wouldgo/eth-camera/hardware/tray.stl

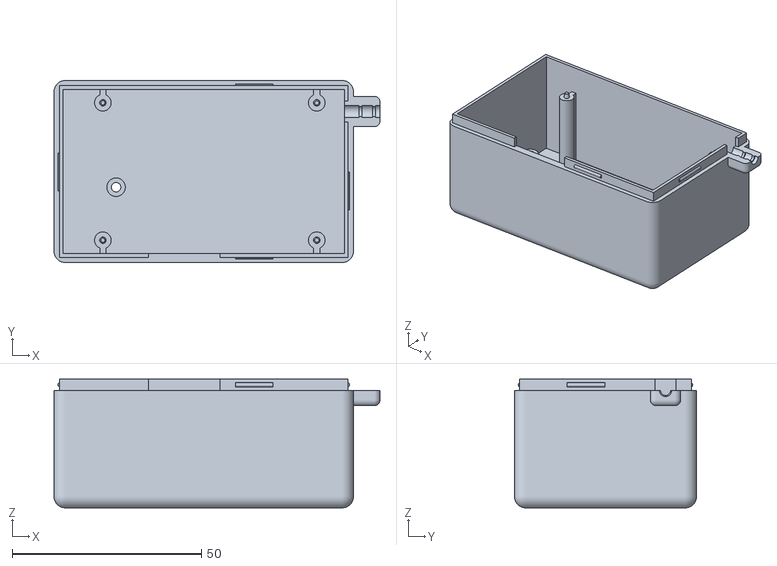
[picture p1: CAD file, 2026-10-19]
hardware/tray.stl
86.1 x 48.1 x 34.0
