wouldgo/eth-camera/hardware/meter_mount.stl

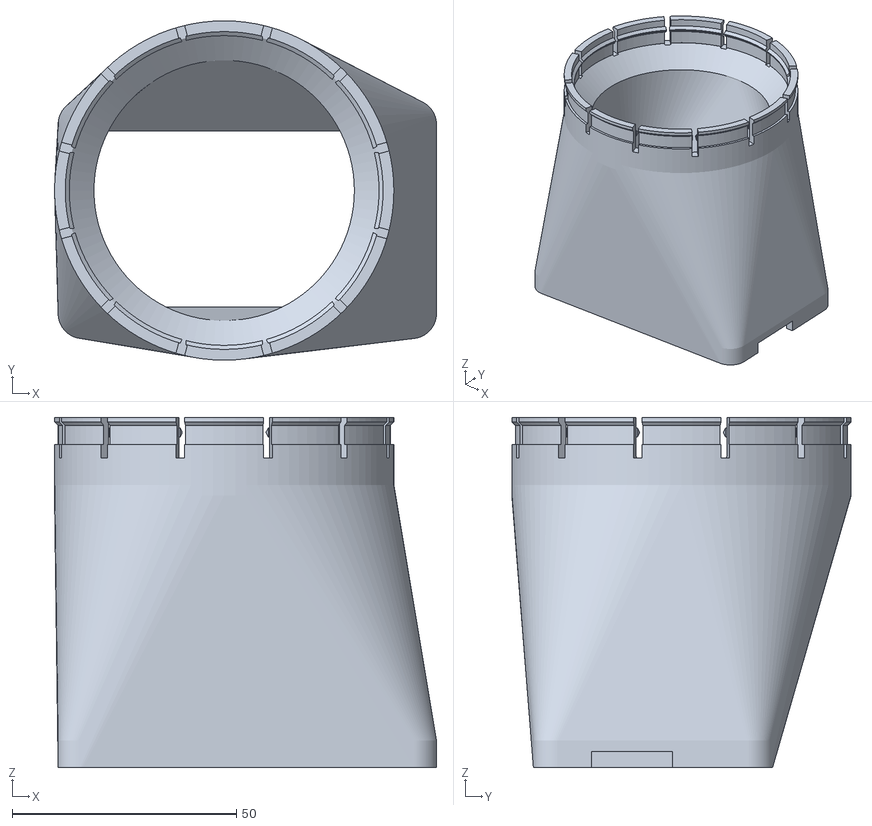
[picture p2: CAD file, 2026-10-19]
hardware/meter_mount.stl
85.1 x 75.6 x 78.0
