wouldgo/eth-camera/hardware/lid.stl

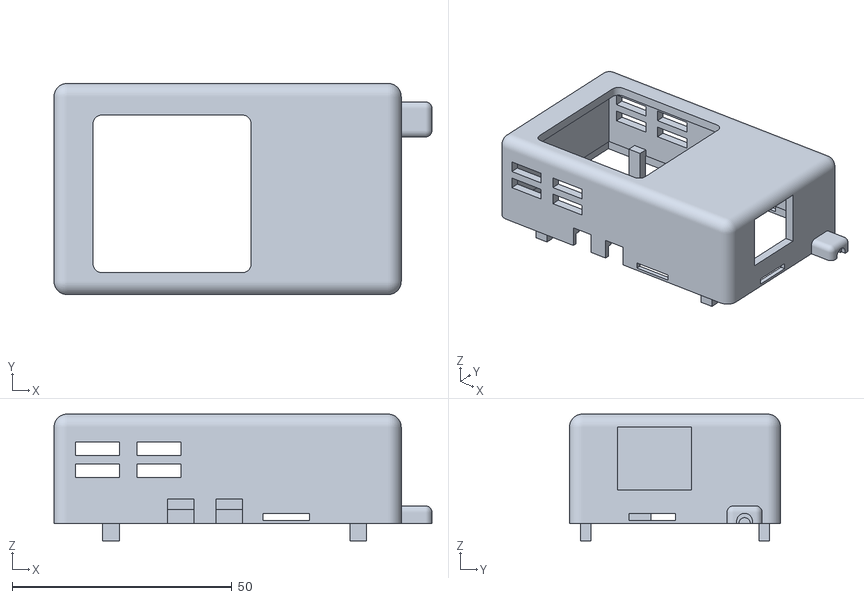
[picture p3: CAD file, 2026-10-19]
hardware/lid.stl
86.1 x 48.1 x 28.9
