wouldgo/eth-camera/hardware/eth-camera.kicad_sch

## KiCad design hardware/eth-camera.kicad_sch (2026-10-19)

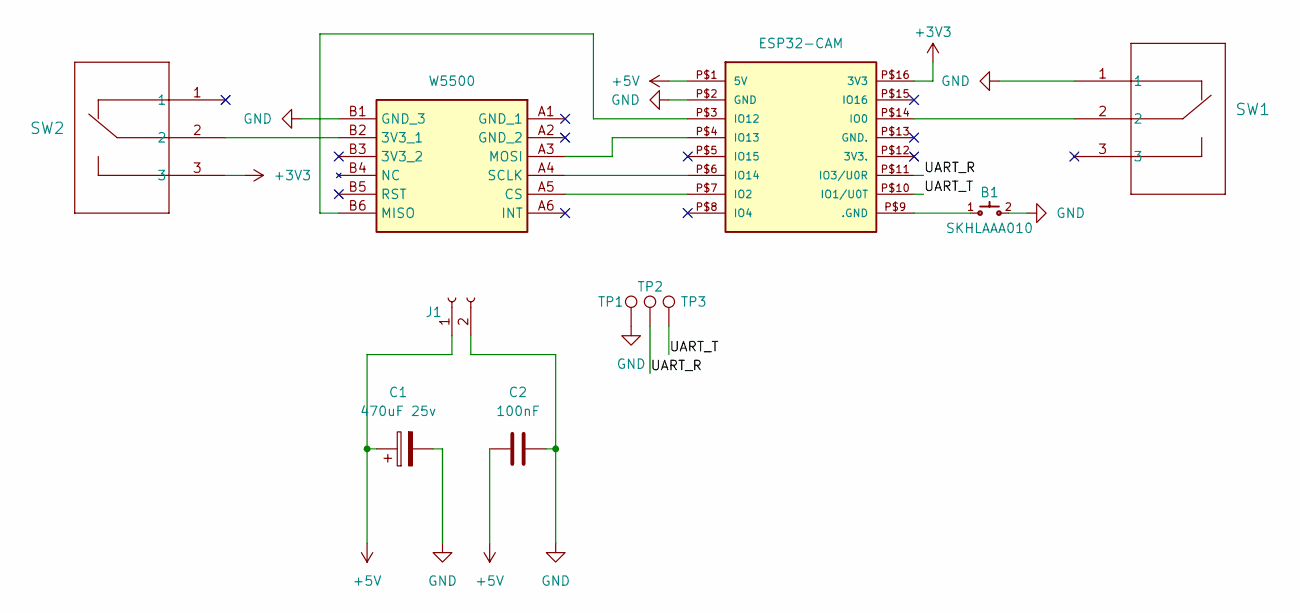
[picture p4: schematic eth-camera.kicad_sch]

Parts:
B1: SKHLAAA010
C1: 470uF 25v; CP_Radial_D10.0mm_P5.00mm
C2: 100nF; C_Disc_D4.7mm_W2.5mm_P5.00mm
IC1: W5500; USRES1_W_HEADERS; Manufacturer_Part_Number USR-ES1
J1: Conn_01x02_Socket; PinSocket_1x02_P2.54mm_Vertical
SW1, SW2: SS-12D00-G 4 E; 1P2T_SS-12D00_CNK
TP1, TP2, TP3: TestPoint; PinSocket_1x01_P2.54mm_Vertical
U1: ESP32-CAM; ESP32-CAM_W_HEADERS

Connections:
+3V3: SW2.3, U1.P$16 (3V3)
+5V: C1.1, C2.1, J1.1, U1.P$1 (5V)
GND: B1.2, C1.2, C2.2, IC1.B1 (GND_3), J1.2, SW1.1, TP1.1, U1.P$2 (GND)
unnamed: B1.1, U1.P$9 (.GND)
unnamed: IC1.A3 (MOSI), U1.P$4 (IO13)
unnamed: IC1.A4 (SCLK), U1.P$6 (IO14)
unnamed: IC1.A5 (CS), U1.P$7 (IO2)
unnamed: IC1.B2 (3V3_1), SW2.2
unnamed: IC1.B6 (MISO), U1.P$3 (IO12)
unnamed: SW1.2, U1.P$14 (IO0)
UART_R: TP2.1, U1.P$11 (IO3/U0R)
UART_T: TP3.1, U1.P$10 (IO1/U0T)
