wouldgo/eth-camera/main/camera.c

#include <freertos/FreeRTOS.h>
#include <freertos/task.h>
#include <esp_log.h>
#include <nvs_flash.h>
#include <sys/param.h>

#include "camera.h"

#define CAM_PIN_PWDN 32
#define CAM_PIN_RESET -1 //software reset will be performed
#define CAM_PIN_XCLK 0
#define CAM_PIN_SIOD 26
#define CAM_PIN_SIOC 27

#define CAM_PIN_D7 35
#define CAM_PIN_D6 34
#define CAM_PIN_D5 39
#define CAM_PIN_D4 36
#define CAM_PIN_D3 21
#define CAM_PIN_D2 19
#define CAM_PIN_D1 18
#define CAM_PIN_D0 5
#define CAM_PIN_VSYNC 25
#define CAM_PIN_HREF 23
#define CAM_PIN_PCLK 22

#define CAPTURE_WARMUP_FRAMES 5 // frames discarded so exposure adapts to the flash
#define CAPTURE_RETRIES 3

static const char *TAG = "camera";
static camera_config_t camera_config = {
  .pin_pwdn = CAM_PIN_PWDN,
  .pin_reset = CAM_PIN_RESET,
  .pin_xclk = CAM_PIN_XCLK,
  .pin_sccb_sda = CAM_PIN_SIOD,
  .pin_sccb_scl = CAM_PIN_SIOC,

  .pin_d7 = CAM_PIN_D7,
  .pin_d6 = CAM_PIN_D6,
  .pin_d5 = CAM_PIN_D5,
  .pin_d4 = CAM_PIN_D4,
  .pin_d3 = CAM_PIN_D3,
  .pin_d2 = CAM_PIN_D2,
  .pin_d1 = CAM_PIN_D1,
  .pin_d0 = CAM_PIN_D0,
  .pin_vsync = CAM_PIN_VSYNC,
  .pin_href = CAM_PIN_HREF,
  .pin_pclk = CAM_PIN_PCLK,

  //XCLK 20MHz or 10MHz for OV2640 double FPS (Experimental)
  .xclk_freq_hz = 10000000,
  .ledc_timer = LEDC_TIMER_0,
  .ledc_channel = LEDC_CHANNEL_0,

  .pixel_format = PIXFORMAT_JPEG, //YUV422,GRAYSCALE,RGB565,JPEG
  .frame_size = FRAMESIZE_UXGA,      //QQVGA-UXGA, For ESP32, do not use sizes above QVGA when not JPEG. The performance of the ESP32-S series has improved a lot, but JPEG mode always gives better frame rates.

  .jpeg_quality = 12,  //0-63, for OV series camera sensors, lower number means higher quality
  .fb_count = 1,       //When jpeg mode is used, if fb_count more than one, the driver will work in continuous mode.
  .fb_location = CAMERA_FB_IN_PSRAM,
  .grab_mode = CAMERA_GRAB_WHEN_EMPTY,
};

esp_err_t configure_camera(void) {
#if !ESP_CAMERA_SUPPORTED
  ESP_LOGE(TAG, "camera support is not configured for this firmware");
  return ESP_ERR_INVALID_STATE;
#endif

  esp_err_t err = esp_camera_init(&camera_config);
  if (err != ESP_OK) {
    ESP_LOGE(TAG, "camera configuration failed");
  }

  return err;
}

jpeg_image camera_capture() {
  jpeg_image img = { .fb = NULL };

  // Drop stale frames and give auto-exposure time to adapt to the flash
  for (int i = 0; i < CAPTURE_WARMUP_FRAMES; i++) {
    camera_fb_t *fb = esp_camera_fb_get();
    if (!fb) {
      ESP_LOGE(TAG, "camera not responding");
      return img;
    }
    esp_camera_fb_return(fb);
  }

  for (int i = 0; i < CAPTURE_RETRIES && !img.fb; i++) {
    img.fb = esp_camera_fb_get();
  }

  if (!img.fb) {
    ESP_LOGE(TAG, "camera capture failed");
  }

  return img;
}

esp_err_t camera_release(jpeg_image* img) {
  if (!img || !img->fb) {
    return ESP_FAIL;
  }
  esp_camera_fb_return(img->fb);
  img->fb = NULL;
  return ESP_OK;
}
