wouldgo/eth-camera/(commit log)

2026-06-14 feature(camera): http camera + ligth before taking photo, wired to eth
    [eth-camera.kicad_pcb, eth-camera.kicad_sch]
2026-10-19 chore(chassis+board+bugfixing): corrections during testing.
    [board.scad, chassis.scad, eth-camera.kicad_pcb, eth-camera.kicad_sch, lid.stl, meter_mount.scad, meter_mount.stl, tray.stl]
